CovJus01/RFID-Read-Sequence/README.md

# TagSense
### An RFID Smart Tag and Checkout System

You can check out the technical documentation of the project [here](./TagSense_Report.pdf). It has a comprehensive breakdown of the process and the technical implementation of the project. A demonstration video of the project can also be viewed [here](https://drive.google.com/file/d/16k3iEqy0laJgcq2kPpJkAAOO3c_OZ6ZU/view?usp=sharing).
