CovJus01/RFID-Read-Sequence/actuator_signaling/flashing_cct.png

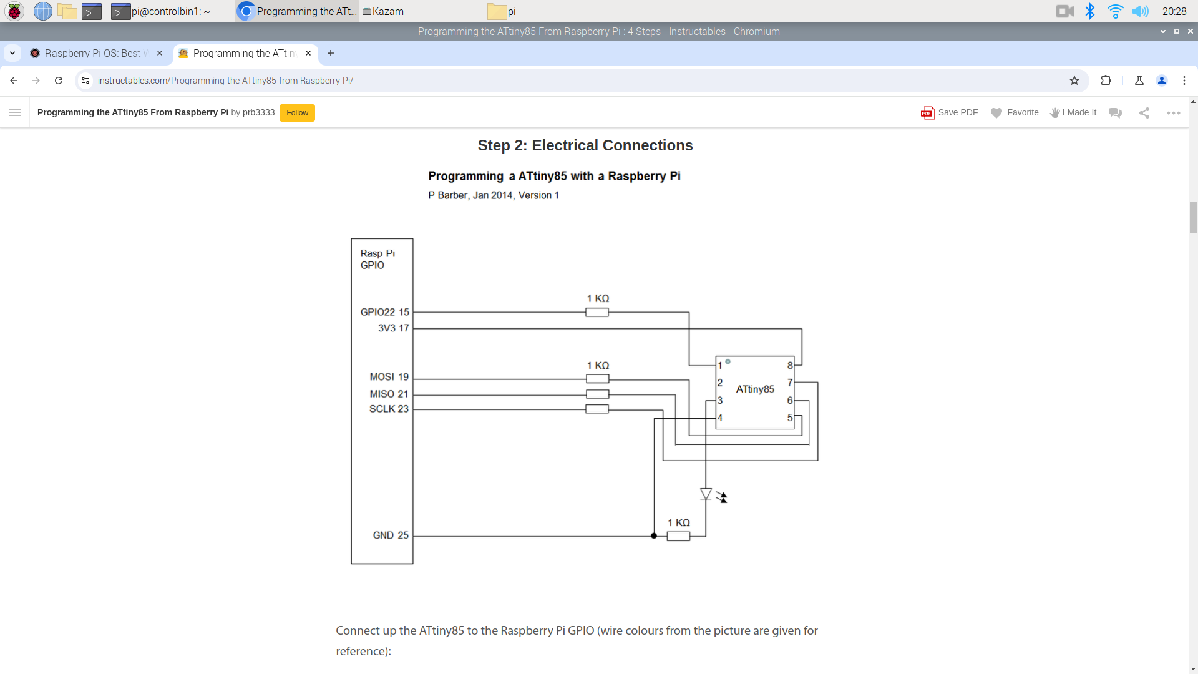
actuator_signaling/flashing_cct.png
