CovJus01/RFID-Read-Sequence/ui_gtk3/ver1/images/insert_clothes.png

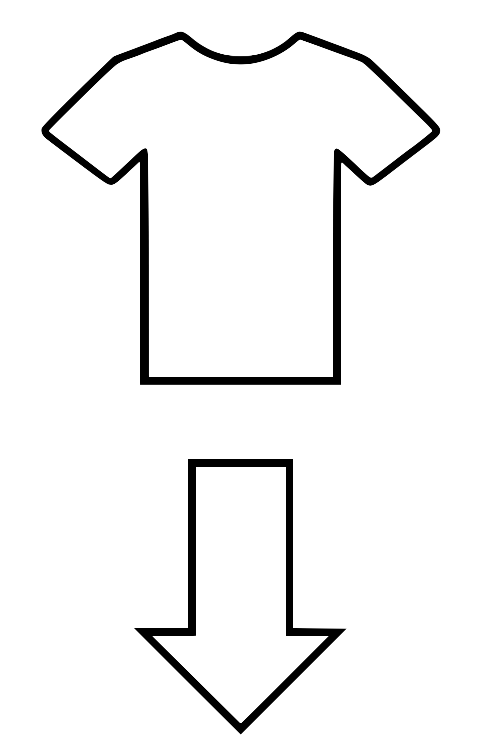
ui_gtk3/ver1/images/insert_clothes.png
