CovJus01/RFID-Read-Sequence/ui_gtk3/ver1/images/payment_options.png

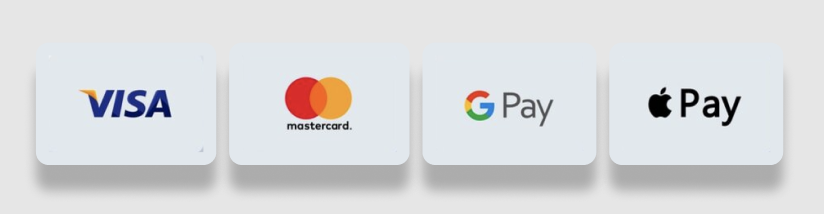
ui_gtk3/ver1/images/payment_options.png
