CovJus01/RFID-Read-Sequence/ui_gtk3/actuator_test1/actuator_signal_send.h

#include <stdio.h>
#include "/home/pi/actuator_signaling/rc-switch/RCSwitch.h" //must clone git project rc-switch to appropriate location

#define GPIO_PIN 17
#define SEND_LEN_BITS 16

int send_actuator_code_16bit(uint16_t code);
