CovJus01/RFID-Read-Sequence/(commit log)

2025-01-16 Added Mercury API for C
    [mercuryapi.cfg]
2025-03-12 Debug for system done, Need to complete DB implementation
    [mercuryapi.cfg]
2025-03-12 Adds actuator signaling code; old and new code to be integrated
2025-03-14 Cleanup + DB functions working, need to implement flow better
2025-03-25 Adds ATtiny flashing circuit diagram
2025-03-28 Adds simple tagsense ui with threading
2025-03-30 RFID reader works with start button, populates checkout store
2025-03-30 Adds refresh button and tx compilation to GUI ver0
2025-04-01 Fixes unregistered tags crashing ui
    [DB_utils.c]
2025-04-02 Adds tag assign button on admin page
